FontysMinorAR/LevelShifter/README.md

This is an application for the Arduino Nano to test the Level shifter Board
