FontysMinorAR/LevelShifter/PICO/README.md

mkdir build
cd build
PICO_SDK_PATH=../pico-sdk/ cmake ..
make
