FontysMinorAR/LevelShifter/PCB/Schema.pdf

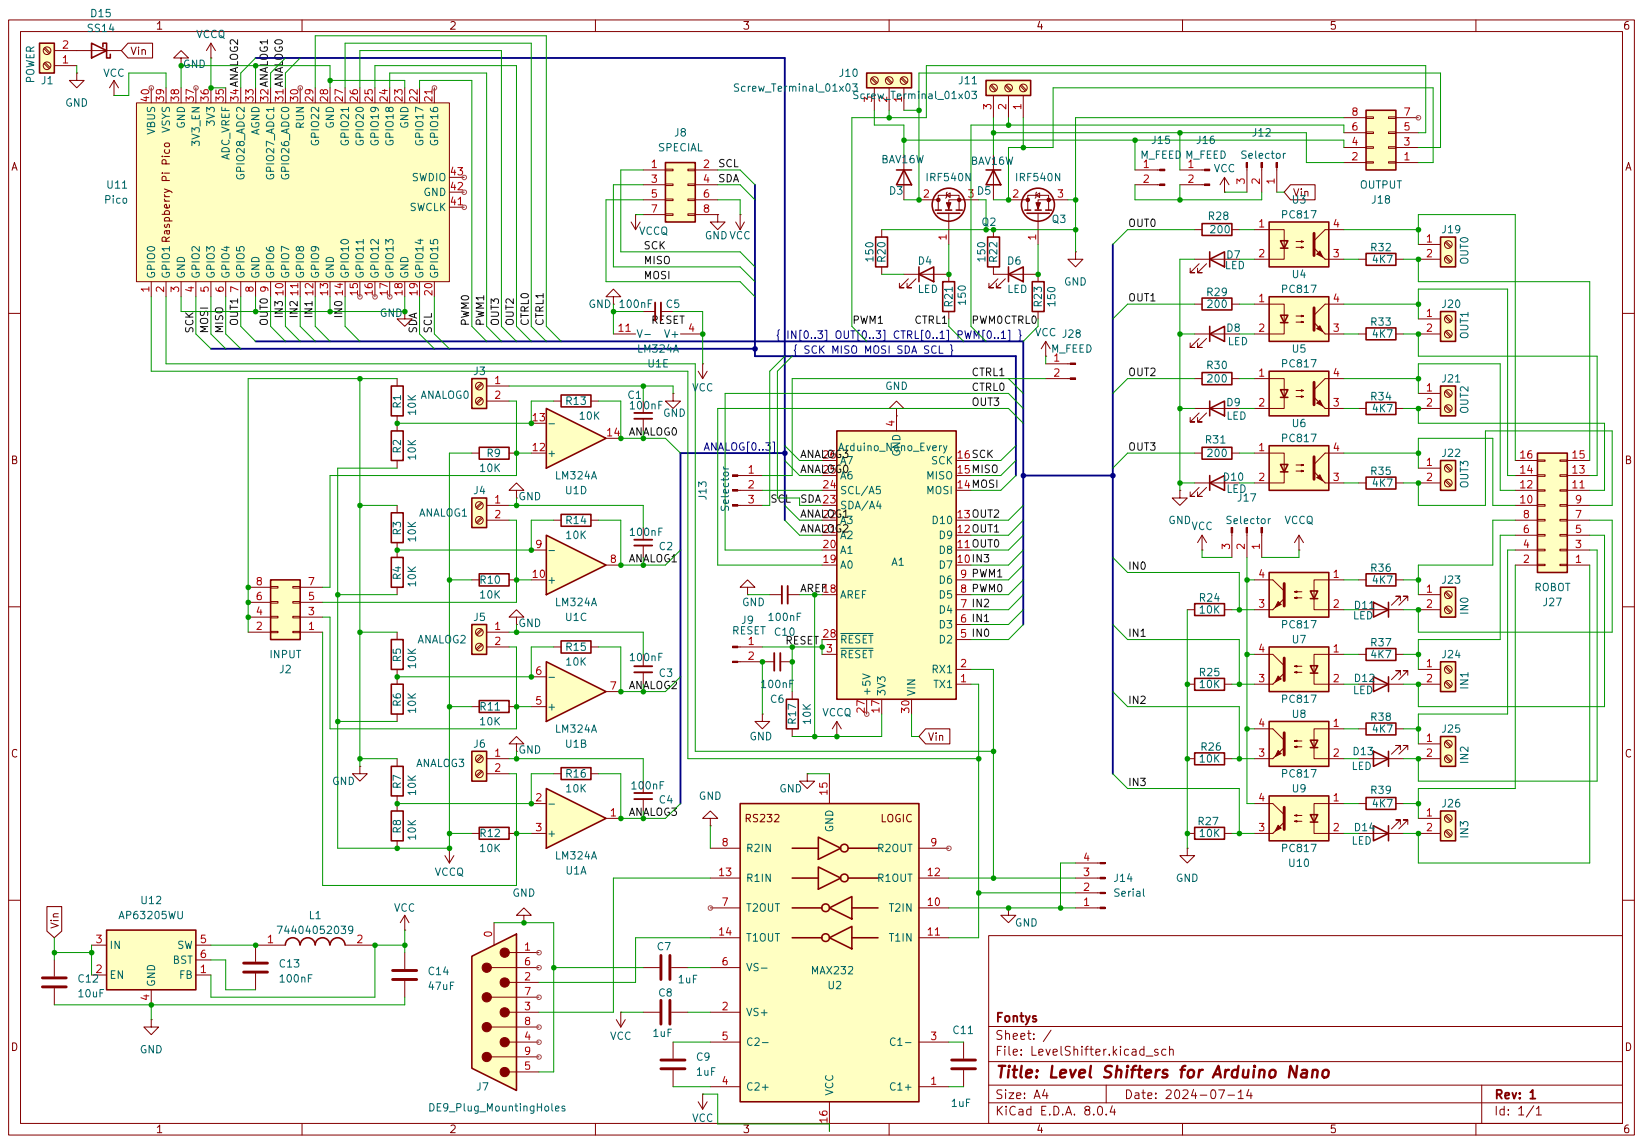
[picture p1: page 1]
