FontysMinorAR/LevelShifter/PCB/LevelShifter.kicad_pcb

## KiCad design PCB/LevelShifter.kicad_pcb (2024-12-04)

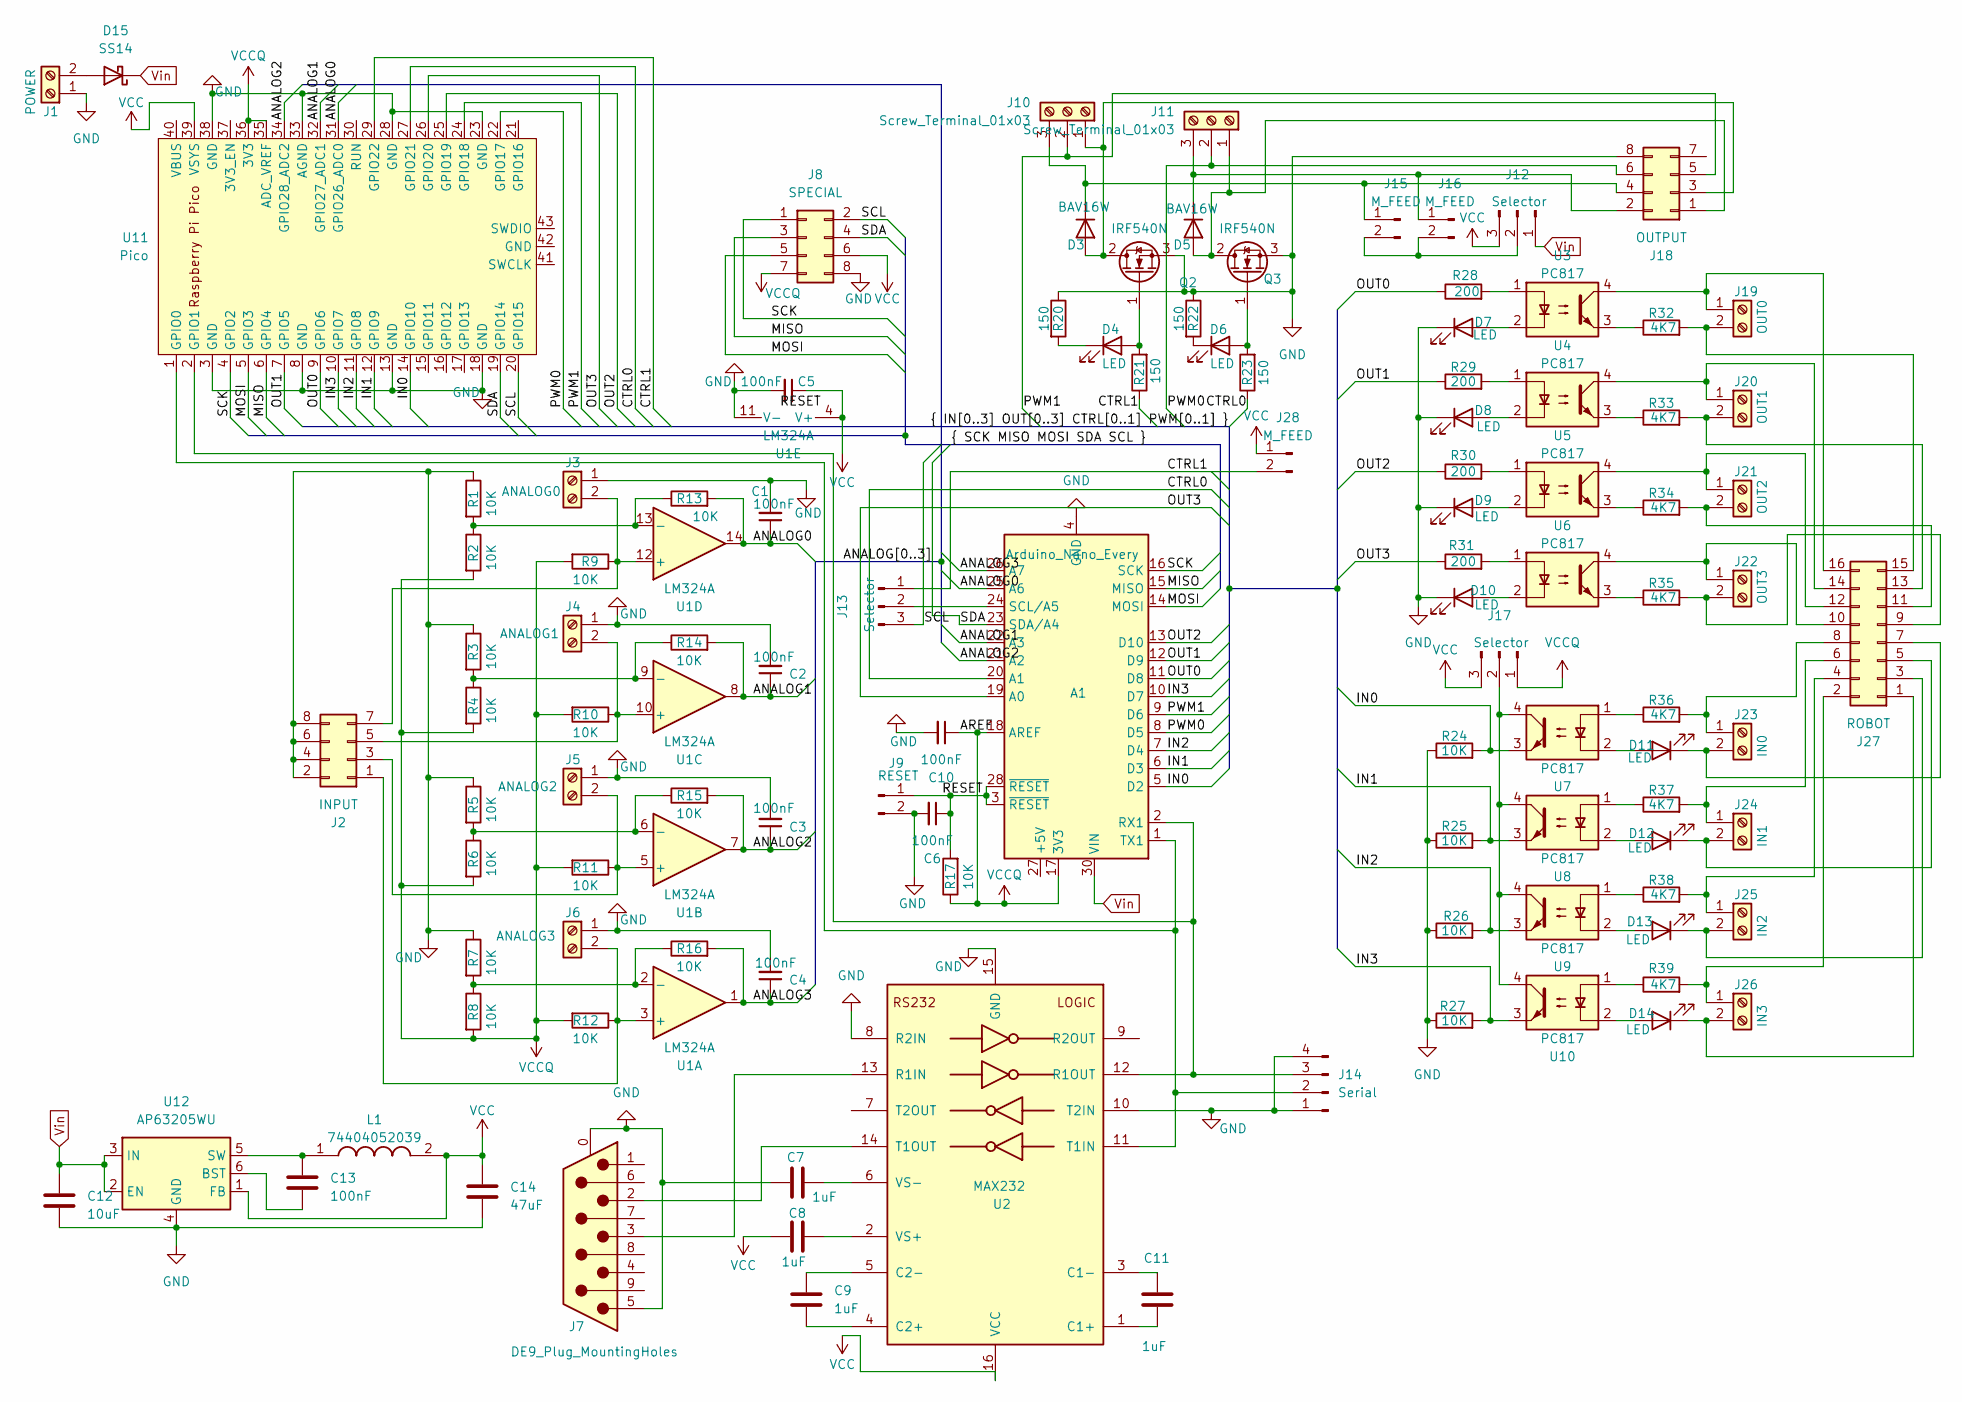
[picture p2: schematic LevelShifter.kicad_sch, Level Shifters for Arduino Nano]

Parts:
A1: Arduino_Nano_Every; Arduino_Nano
C1, C2, C3, C4, C5, C6, C10: 100nF; C_0805_2012Metric
C7, C8, C9, C11: 1uF; C_1206_3216Metric_Pad1.33x1.80mm_HandSolder
C12: 10uF; C_1206_3216Metric_Pad1.33x1.80mm_HandSolder
C13: 100nF; C_0805_2012Metric_Pad1.18x1.45mm_HandSolder
C14: 47uF; C_1206_3216Metric_Pad1.33x1.80mm_HandSolder
D3, D5: BAV16W; D_SOD-123
D4, D6, D7, D8, D9, D10, D11, D12, D13, D14: LED; LED_D5.0mm
D15: SS14; D_SMA
J1: POWER; TerminalBlock_MetzConnect_Type101_RT01602HBWC_1x02_P5.08mm_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
J2: INPUT; PinSocket_2x04_P2.54mm_Vertical
J3: ANALOG0; TerminalBlock_MetzConnect_Type101_RT01602HBWC_1x02_P5.08mm_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
J4: ANALOG1; TerminalBlock_MetzConnect_Type101_RT01602HBWC_1x02_P5.08mm_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
J5: ANALOG2; TerminalBlock_MetzConnect_Type101_RT01602HBWC_1x02_P5.08mm_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
J6: ANALOG3; TerminalBlock_MetzConnect_Type101_RT01602HBWC_1x02_P5.08mm_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
J7: DE9_Plug_MountingHoles; DSUB-9_Female_Horizontal_P2.77x2.84mm_EdgePinOffset4.94mm_H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
J8: SPECIAL; PinSocket_2x04_P2.54mm_Vertical
J9: RESET; PinSocket_1x02_P2.54mm_Vertical
J10, J11: Screw_Terminal_01x03; TerminalBlock_MetzConnect_Type011_RT05503HBWC_1x03_P5.00mm_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
J12, J13, J17: Selector; PinHeader_1x03_P2.54mm_Vertical
J14: Serial; PinSocket_1x04_P2.54mm_Vertical
J15, J16, J28: M_FEED; PinSocket_1x02_P2.54mm_Vertical
J18: OUTPUT; PinSocket_2x04_P2.54mm_Vertical
J19: OUT0; TerminalBlock_MetzConnect_Type101_RT01602HBWC_1x02_P5.08mm_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
J20: OUT1; TerminalBlock_MetzConnect_Type101_RT01602HBWC_1x02_P5.08mm_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
J21: OUT2; TerminalBlock_MetzConnect_Type101_RT01602HBWC_1x02_P5.08mm_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
J22: OUT3; TerminalBlock_MetzConnect_Type101_RT01602HBWC_1x02_P5.08mm_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
J23: IN0; TerminalBlock_MetzConnect_Type101_RT01602HBWC_1x02_P5.08mm_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
J24: IN1; TerminalBlock_MetzConnect_Type101_RT01602HBWC_1x02_P5.08mm_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
J25: IN2; TerminalBlock_MetzConnect_Type101_RT01602HBWC_1x02_P5.08mm_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
J26: IN3; TerminalBlock_MetzConnect_Type101_RT01602HBWC_1x02_P5.08mm_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
J27: ROBOT; PinSocket_2x08_P2.54mm_Vertical
L1: 74404052039; CD75; Manufacturer_Part_Number 74404052039
Q2, Q3: IRF540N; TO-220-3_Vertical
R1, R2, R3, R4, R5, R6, R7, R8, R9, R10, R11, R12, R13, R14, R15, R16, R17, R24, R25, R26, R27: 10K; R_Axial_DIN0207_L6.3mm_D2.5mm_P7.62mm_Horizontal
R20, R21, R22, R23: 150; R_Axial_DIN0207_L6.3mm_D2.5mm_P7.62mm_Horizontal
R28, R29, R30, R31: 200; R_Axial_DIN0207_L6.3mm_D2.5mm_P7.62mm_Horizontal
R32, R33, R34, R35, R36, R37, R38, R39: 4K7; R_Axial_DIN0207_L6.3mm_D2.5mm_P7.62mm_Horizontal
U1: LM324A; DIP-14_W7.62mm
U2: MAX232; DIP-16_W7.62mm
U3, U4, U5, U6, U7, U8, U9, U10: PC817; DIP-4_W7.62mm
U11: Pico; pico
U12: AP63205WU; TSOT-23-6

Connections:
/ANALOG0: A1.25 (A6), C1.1, R13.2, U1.14, U11.31 (GPIO26_ADC0)
/ANALOG1: A1.22 (A3), C2.1, R14.2, U1.8, U11.32 (GPIO27_ADC1)
/ANALOG2: A1.21 (A2), C3.1, R15.2, U1.7, U11.34 (GPIO28_ADC2)
/ANALOG3: A1.26 (A7), C4.1, R16.2, U1.1
/CTRL0: A1.20 (A1), R23.1, U11.27 (GPIO21)
/CTRL1: J13.1, J28.2, R21.1, U11.29 (GPIO22)
/IN0: A1.5 (D2), R24.2, U7.3, U11.14 (GPIO10)
/IN1: A1.6 (D3), R25.2, U8.3, U11.12 (GPIO9)
/IN2: A1.7 (D4), R26.2, U9.3, U11.11 (GPIO8)
/IN3: A1.10 (D7), R27.2, U10.3, U11.10 (GPIO7)
/MISO: A1.15 (MISO), J8.3, U11.6 (GPIO4)
/MOSI: A1.14 (MOSI), J8.5, U11.5 (GPIO3)
/OUT0: A1.11 (D8), R28.1, U11.9 (GPIO6)
/OUT1: A1.12 (D9), R29.1, U11.7 (GPIO5)
/OUT2: A1.13 (D10), R30.1, U11.25 (GPIO19)
/OUT3: A1.19 (A0), R31.1, U11.26 (GPIO20)
/PWM0: A1.8 (D5), J11.2, J18.6, U11.22 (GPIO17)
/PWM1: A1.9 (D6), J10.2, J18.5, U11.24 (GPIO18)
/RESET: A1.3 (~RESET), A1.28 (~RESET), C6.1, J9.1, R17.2
/SCK: A1.16 (SCK), J8.1, U11.4 (GPIO2)
/SCL: J8.2, J13.3, U11.20 (GPIO15)
/SDA: A1.23 (SDA/A4), J8.4, U11.19 (GPIO14)
GND: A1.4 (GND), A1.29 (GND), C1.2, C2.2, C3.2, C4.2, C5.2, C6.2, C7.1, C10.2, C12.2, C14.2, D7.1 (K), D8.1 (K), D9.1 (K), D10.1 (K), J1.1, J2.2, J2.4, J2.6, J2.8, J3.1, J4.1, J5.1, J6.1, J7.0 (PAD), J7.5, J8.8, J9.2, J14.1, J14.4, J18.8, Q2.3 (S), Q3.3 (S), R1.1, R3.1, R5.1, R7.1, R20.1, R22.1, R24.1, R25.1, R26.1, R27.1, U1.11 (V-), U2.8 (R2IN), U2.10 (T2IN), U2.15 (GND), U11.3 (GND), U11.8 (GND), U11.13 (GND), U11.18 (GND), U11.23 (GND), U11.28 (GND), U11.33 (AGND), U11.38 (GND), U12.4 (GND)
unnamed: A1.2 (RX1), J14.3, U2.12 (R1OUT), U11.2 (GPIO1)
unnamed: A1.24 (SCL/A5), J13.2
unnamed: A1.1 (TX1), J14.2, U2.11 (T1IN), U11.1 (GPIO0)
unnamed: D3.2 (A), J10.1, J18.3, Q2.2 (D)
unnamed: D3.1 (K), J10.3, J15.1, J18.4
unnamed: D4.2 (A), Q2.1 (G), R21.2
unnamed: D4.1 (K), R20.2
unnamed: D5.2 (A), J11.1, J18.1, Q3.2 (D)
unnamed: D5.1 (K), J11.3, J16.1, J18.2
unnamed: D6.2 (A), Q3.1 (G), R23.2
unnamed: D6.1 (K), R22.2
unnamed: D7.2 (A), U3.2
unnamed: D8.2 (A), U4.2
unnamed: D9.2 (A), U5.2
unnamed: D10.2 (A), U6.2
unnamed: D11.2 (A), U7.2
unnamed: D11.1 (K), J23.2, J27.7
unnamed: D12.2 (A), U8.2
unnamed: D12.1 (K), J24.2, J27.5
unnamed: D13.2 (A), U9.2
unnamed: D13.1 (K), J25.2, J27.3
unnamed: D14.2 (A), U10.2
unnamed: D14.1 (K), J26.2, J27.1
unnamed: D15.2 (A), J1.2
unnamed: J2.1, J6.2, R12.1, U1.3 (+)
unnamed: J2.3, J5.2, R11.1, U1.5 (+)
unnamed: J2.5, J4.2, R10.1, U1.10 (+)
unnamed: J2.7, J3.2, R9.1, U1.12 (+)
unnamed: J12.2, J15.2, J16.2
unnamed: J17.2, U7.4, U8.4, U9.4, U10.4
unnamed: J19.1, J27.16, U3.4
unnamed: J19.2, J27.15, R32.2
unnamed: J20.1, J27.14, U4.4
unnamed: J20.2, J27.13, R33.2
unnamed: J21.1, J27.12, U5.4
unnamed: J21.2, J27.11, R34.2
unnamed: J22.1, J27.10, U6.4
unnamed: J22.2, J27.9, R35.2
unnamed: J23.1, J27.8, R36.2
unnamed: J24.1, J27.6, R37.2
unnamed: J25.1, J27.4, R38.2
unnamed: J26.1, J27.2, R39.2
unnamed: R28.2, U3.1
unnamed: R29.2, U4.1
unnamed: R30.2, U5.1
unnamed: R31.2, U6.1
unnamed: R32.1, U3.3
unnamed: R33.1, U4.3
unnamed: R34.1, U5.3
unnamed: R35.1, U6.3
unnamed: R36.1, U7.1
unnamed: R37.1, U8.1
unnamed: R38.1, U9.1
unnamed: R39.1, U10.1
unnamed: R7.2, R8.1, R16.1, U1.2 (-)
unnamed: R5.2, R6.1, R15.1, U1.6 (-)
unnamed: R3.2, R4.1, R14.1, U1.9 (-)
unnamed: R1.2, R2.1, R13.1, U1.13 (-)
unnamed: C11.1, U2.1 (C1+)
unnamed: C11.2, U2.3 (C1-)
unnamed: C9.1, U2.4 (C2+)
unnamed: C9.2, U2.5 (C2-)
unnamed: J7.3, U2.13 (R1IN)
unnamed: J7.2, U2.14 (T1OUT)
unnamed: C8.2, U2.2 (VS+)
unnamed: C7.2, U2.6 (VS-)
unnamed: C13.2, U12.6 (BST)
unnamed: C13.1, L1.1, U12.5 (SW)
VCC: C5.1, C8.1, C14.1, J8.6, J12.3, J17.3, J28.1, L1.2, U1.4 (V+), U2.16 (VCC), U11.39 (VSYS), U12.1 (FB)
VCCQ: A1.17 (3V3), A1.18 (AREF), C10.1, J8.7, J17.1, R2.2, R4.2, R6.2, R8.2, R9.2, R10.2, R11.2, R12.2, R17.1, U11.35 (ADC_VREF), U11.36 (3V3)
Vin: A1.30 (VIN), C12.1, D15.1 (K), J12.1, U12.2 (EN), U12.3 (IN)

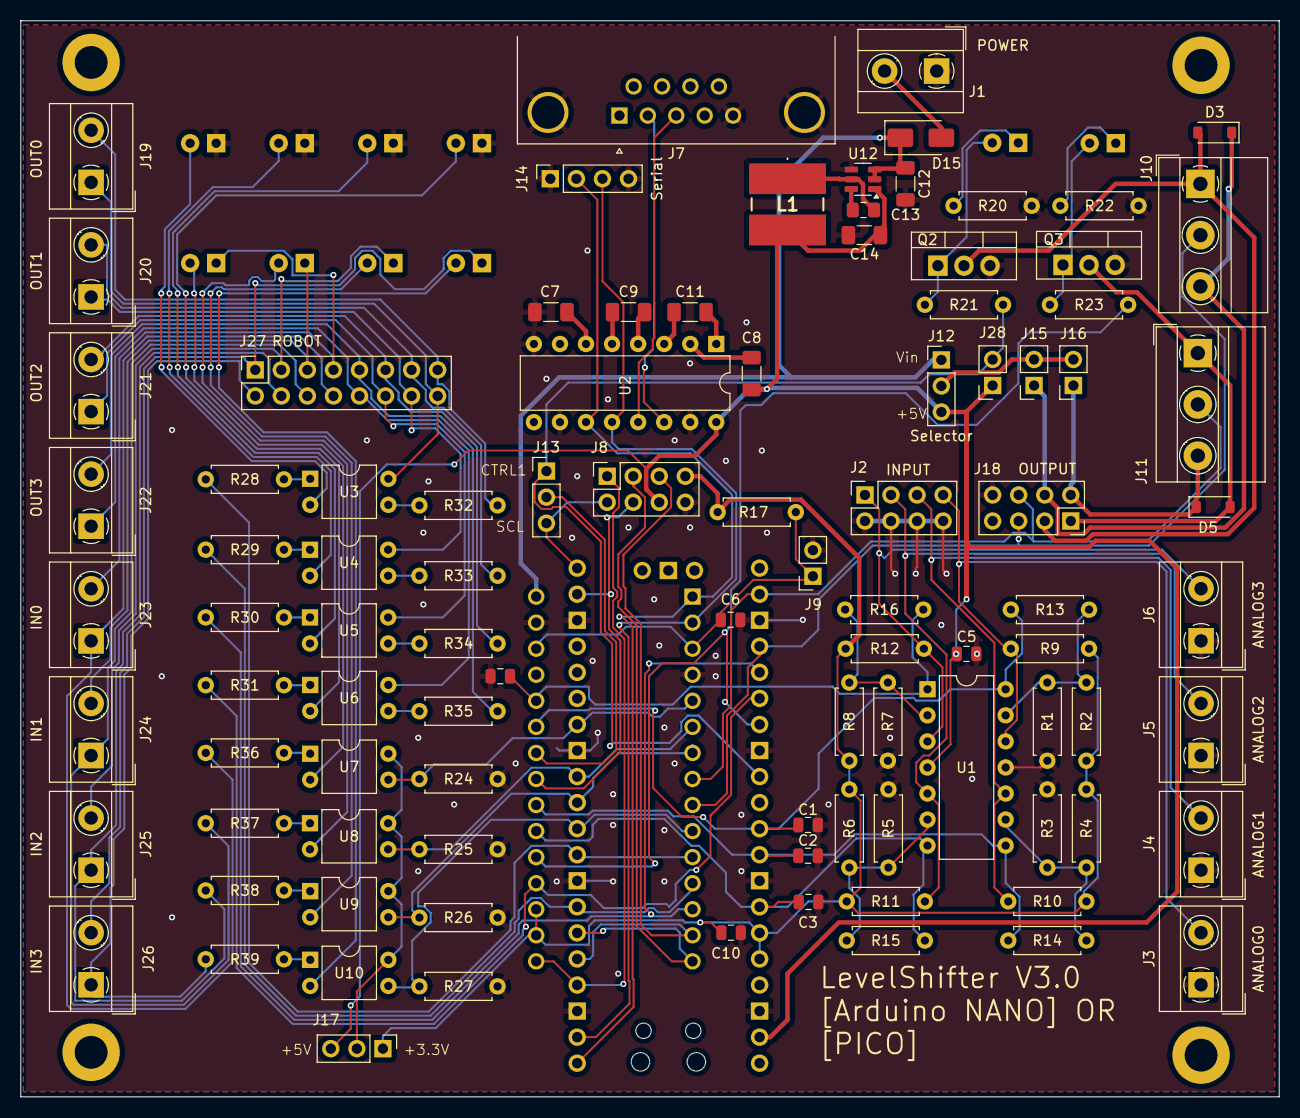
[picture p3: board LevelShifter.kicad_pcb from above]

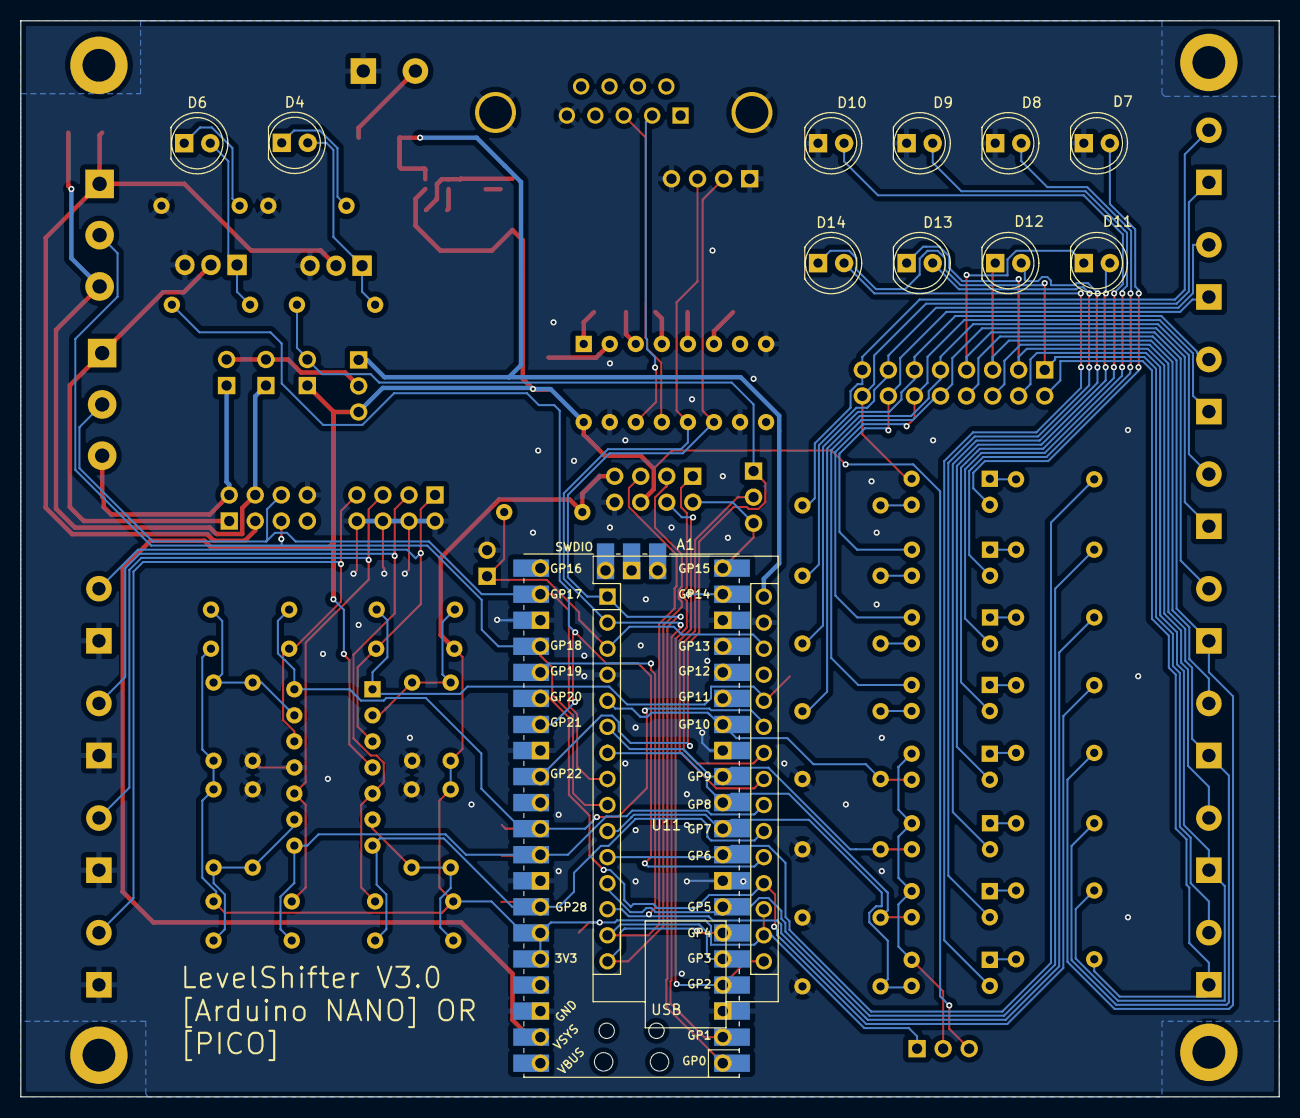
[picture p4: board LevelShifter.kicad_pcb from below]

Board: 2 copper layers, 122.7 x 104.9 mm, 108 parts (12 on the bottom side), 94 nets.
