FontysMinorAR/LevelShifter/(commit log)

2024-08-13 [Functionalities] servomotor & forceSensor
2024-08-20 [SYNC] Initial commit of the level shifter. Still need to fill in the sleected resitor values.
    [LevelShifter.kicad_pcb, LevelShifter.kicad_sch]
2024-09-01 [ARDUINO] Make PWM available for Servo motor (5V from buck circuit. PW on pinout) [PICO] Allow design for RaspberryPi Pico placement
    [LevelShifter.kicad_pcb, LevelShifter.kicad_sch]
2024-09-02 [UPDATE] outing done. Start the final touch!
    [LevelShifter.kicad_pcb, LevelShifter.kicad_sch]
2024-09-02 [COMPLETED] All tracks laid. Wiaitng for the production of the PCB.
    [LevelShifter.kicad_pcb, LevelShifter.kicad_sch]
2025-02-07 [PICO[ Add a PIC C code example for the LevelShifter PCB.
